Lahhamix/FYP-codebase/backend/README.md

# SoleMate Email Backend

This service relays email requests from the Android app to SendGrid.

## 1) Configure environment

Create `.env` in this folder (or copy from `.env.example`):

```
PORT=3000
SENDGRID_API_KEY=your_sendgrid_api_key_here
SENDGRID_FROM_EMAIL=your_verified_sender@example.com
SENDGRID_API_BASE_URL=https://api.sendgrid.com
```

## 2) Start backend

```bash
npm install
npm start
```

Backend health check:

- `GET http://localhost:3000/health` should return `{ "ok": true }`

## 3) Email verification API

The backend now exposes two endpoints for the Android app:

- `POST /auth/request-email-verification`
	- Body: `{ "email": "name@example.com", "username": "Jane" }`
	- Sends a verification email and starts the resend cooldown.
- `POST /auth/verify-email-code`
	- Body: `{ "email": "name@example.com", "code": "123456" }`
	- Verifies the code, marks the email as verified, and invalidates the pending code.

The verification email uses the SoleMate HTML template bundled in `server.js`.

## 4) Make app use one shared backend URL

Set one public backend URL in project `gradle.properties` (checked into git):

```
EMAIL_BACKEND_BASE_URL=https://your-public-backend.example.com
EMAIL_BACKEND_BASE_URL_DEBUG=https://your-public-backend.example.com
EMAIL_BACKEND_BASE_URL_RELEASE=https://your-public-backend.example.com
```

Notes:
- `EMAIL_BACKEND_BASE_URL_DEBUG` and `EMAIL_BACKEND_BASE_URL_RELEASE` override `EMAIL_BACKEND_BASE_URL` if set.
- Do not commit backend secrets or `.env`.
- App email sending now uses backend relay only (no direct SendGrid fallback from Android).
