Lahhamix/FYP-codebase/FYP_Template_Spring/1_cover.tex

\begin{titlepage}
\begin{center}

\LARGE{AMERICAN UNIVERSITY OF BEIRUT\\}
\vspace{3cm}

\LARGE{Project 46 - Spring Semester:\\
       SoleMate: A Custom Foot Pressure and Health Monitoring System\\} 
\vspace{1cm}

\normalsize{by\\ ~\\} 
\Large{ Raghad Al Agha, Control and Intelligence Systems - Biomedical Engineering Design \\
        Lynn Ariss, Software Systems - AI and Machine Learning \\
        Hadi Elham, Computer Hardware Systems  - AI and Machine Learning \\
        %or Control and Intelligence Systems
        Claritta Khoury, Control and Intelligence Systems - Biomedical Engineering Design \\
        ~\\
        Advisor: Ayman Kayssi\\
         Co-Advisor: Massoud Khraiche\\ 
         ~\\
    }  
\vspace{1cm}

\normalsize{A final year project\\}
\normalsize{submitted in partial fulfillment of the requirements\\}
\normalsize{for the degree of Bachelor of Engineering\\}
\small{to the Department of Electrical and Computer Engineering\\}
\normalsize{of the Maroun Semaan Faculty of Engineering and Architecture (MSFEA)\\}
\normalsize{at the American University of Beirut\\} 
\normalsize{Beirut, Lebanon\\
} 
\end{center}
\end{titlepage}
