Lahhamix/FYP-codebase/FYP_Template_Spring/Figures/3_mux .jpeg

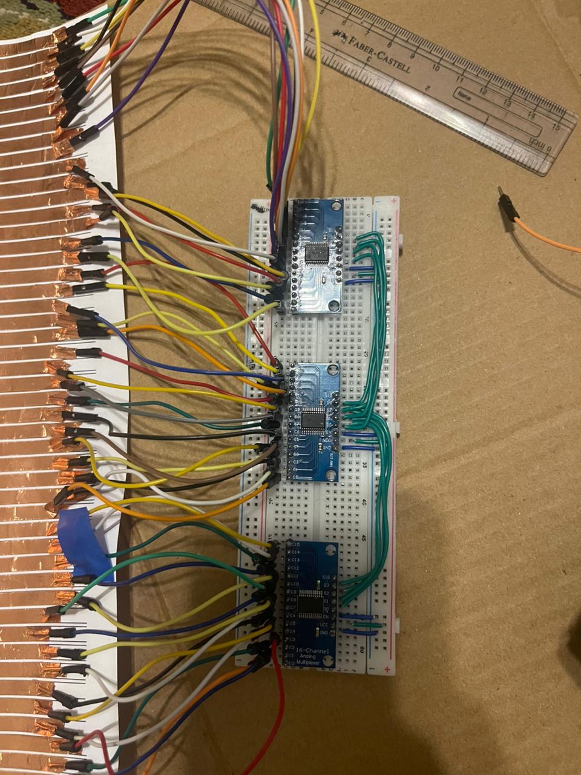
FYP_Template_Spring/Figures/3_mux .jpeg
