Lahhamix/FYP-codebase/FYP_Template_Spring/Figures/Alert_disbled.png

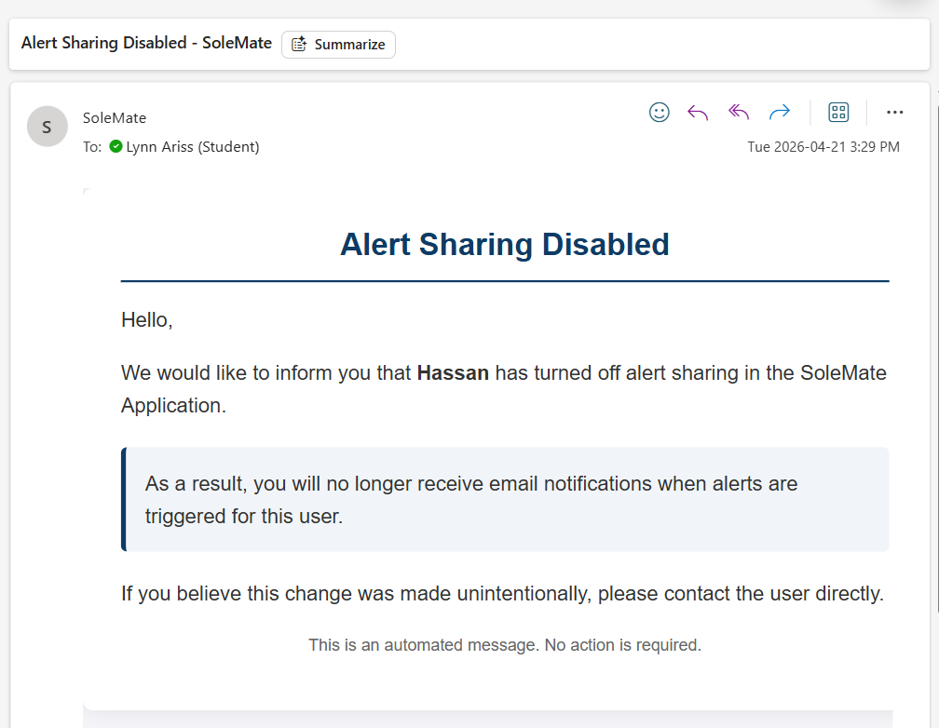
FYP_Template_Spring/Figures/Alert_disbled.png
