Lahhamix/FYP-codebase/FYP_Template_Spring/Figures/L.jpg

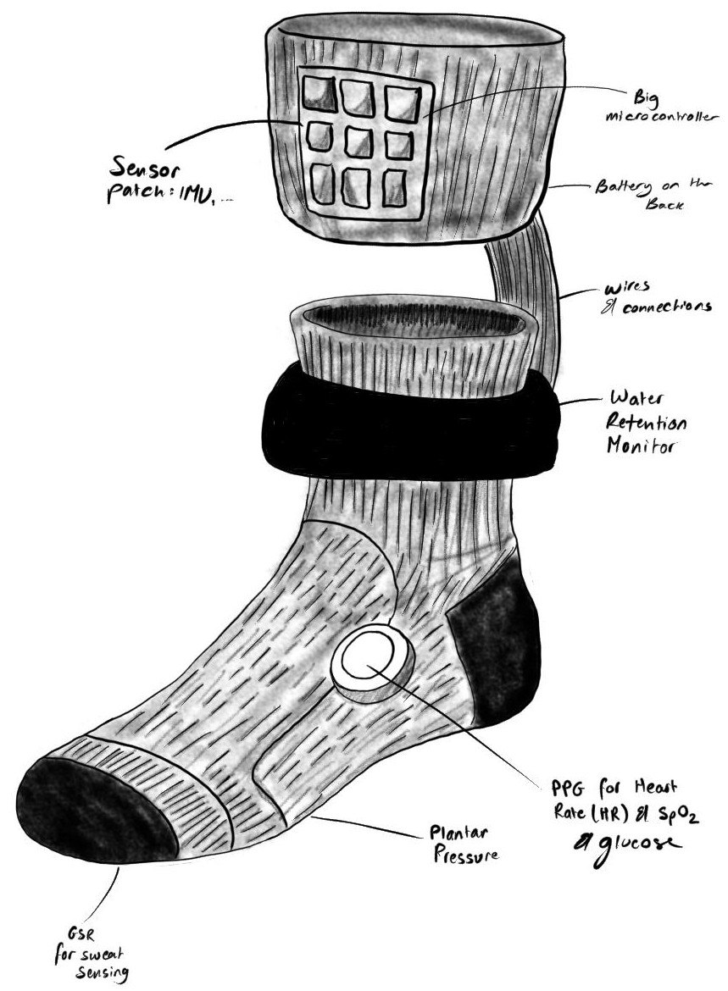
FYP_Template_Spring/Figures/L.jpg
