Lahhamix/FYP-codebase/FYP_Template_Spring/Figures/Mat.jpg

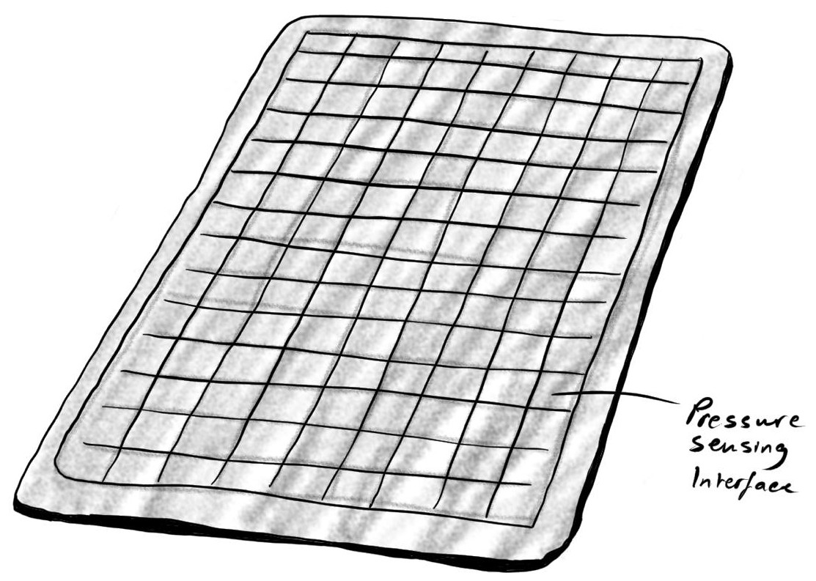
FYP_Template_Spring/Figures/Mat.jpg
