Lahhamix/FYP-codebase/FYP_Template_Spring/Figures/Remove_a_preson_from_sharing.png

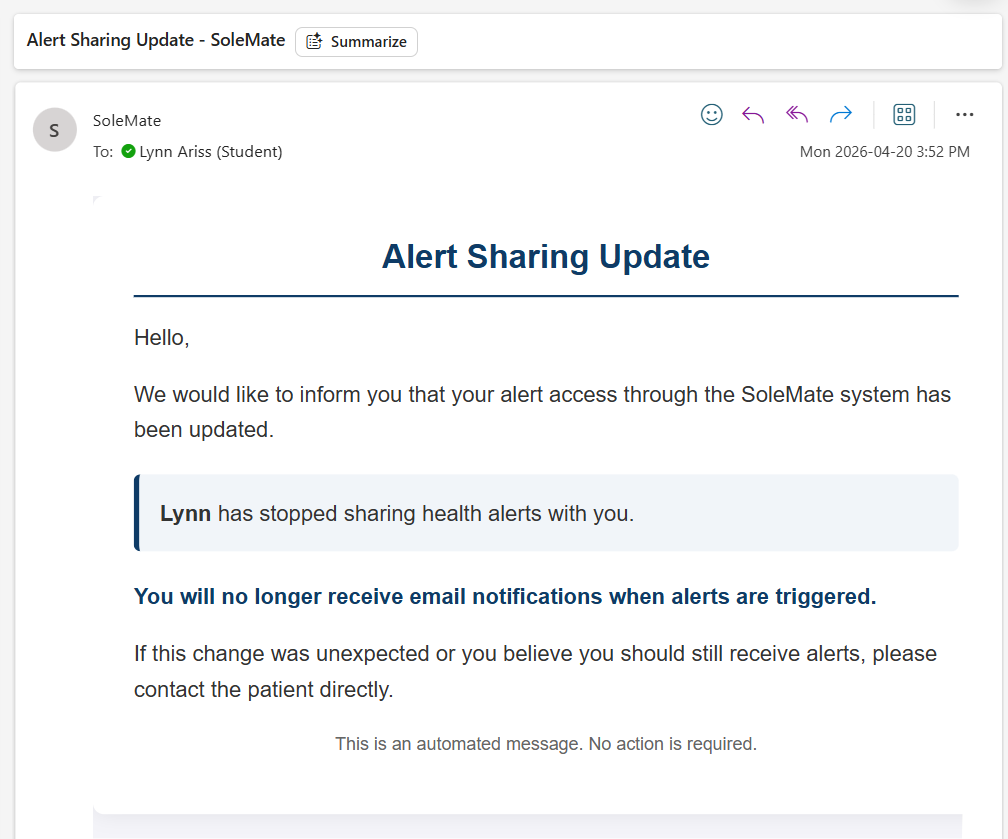
FYP_Template_Spring/Figures/Remove_a_preson_from_sharing.png
