Lahhamix/FYP-codebase/FYP_Template_Spring/Figures/Sock.jpg

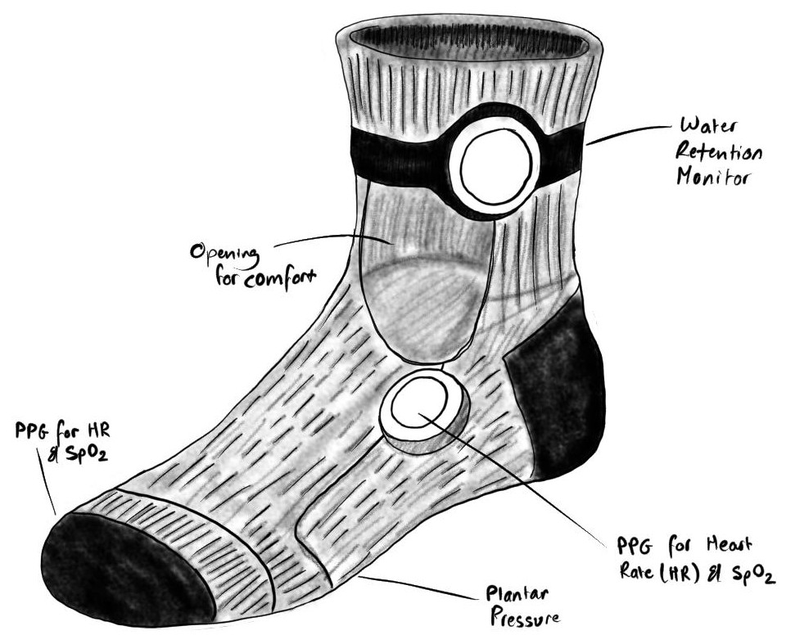
FYP_Template_Spring/Figures/Sock.jpg
