Lahhamix/FYP-codebase/FYP_Template_Spring/Figures/Signup_verification.png

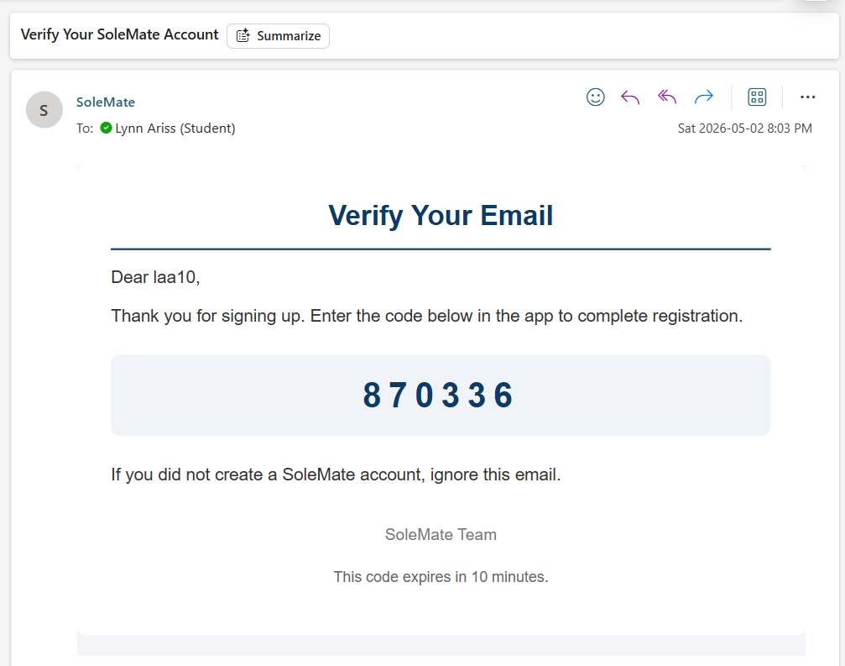
FYP_Template_Spring/Figures/Signup_verification.png
