Lahhamix/FYP-codebase/FYP_Template_Spring/Figures/Verification_alert_receipient.png

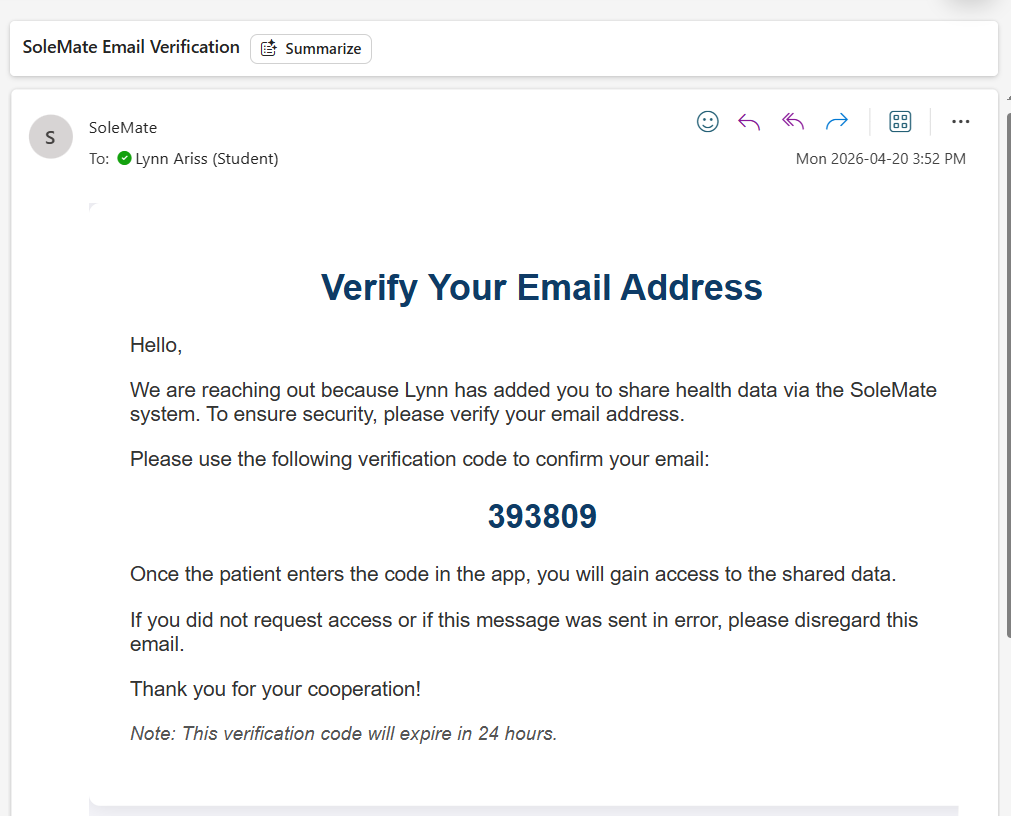
FYP_Template_Spring/Figures/Verification_alert_receipient.png
