Lahhamix/FYP-codebase/DEBUG_REPORT.md

# Backend Email & Signup Debugging Report

## Issue Summary
**Problem:** Signup requests were failing with "Could not send verification code" error on Android app
**Root Cause:** SendGrid API key exhausted its credit limit

---

## Diagnosis Process

### Step 1: Database Verification ✅
- **Status:** Database tables exist and are properly initialized
- **Tables Found:** 14/14 (users, user_profiles, user_settings, email_verification_codes, etc.)
- **Connection:** PostgreSQL on 127.0.0.1:5432 working correctly

### Step 2: Backend API Testing ✅  
- **Status:** Signup API endpoint works correctly (HTTP 201 success)
- **Test Result:** User account created successfully in database
- **Issue Found:** Email service failing silently

### Step 3: Email Service Analysis ✅
**Backend Logs Revealed:**
```
[DEV] SendGrid rejected email: Maximum credits exceeded (dev mode: continuing without email)
```
- SendGrid API key: `SG._guS82BCQKeim68j-XkkEg...` (redacted)
- Error: API key has maxed out its monthly credits
- Impact: Verification emails not being sent

---

## Solution Implemented

### Local Email Testing Mode ✅
To restore functionality while you get a new SendGrid key:

**Enabled:** Local file-based email logging
- **File Location:** `backend/email_log.txt`
- **Mode:** `USE_LOCAL_EMAIL=true` in `.env`
- **Result:** Emails are now logged to text file instead of SendGrid

**Backend Configuration:**
```
# backend/.env
USE_LOCAL_EMAIL=true
```

**Email Log Output Example:**
```
================================================================================
[2026-05-02T06:21:50.593Z]
To: test1777702909865@example.com
Subject: Verify Your SoleMate Account

Body:
Your SoleMate verification code is: 906930. It expires in 10 minutes.
```

---

## Verification Tests

| Test | Result | Status |
|---|---|---|
| PostgreSQL Connection | ✅ Working | PASS |
| Database Tables | ✅ 14/14 tables | PASS |
| User Creation | ✅ Success | PASS |
| Signup API (HTTP 201) | ✅ Success | PASS |
| Email Logging to File | ✅ Success | PASS |

---

## Next Steps

### Option 1: Restore SendGrid Email (Recommended)
When you have a new SendGrid API key:

1. Update `backend/.env`:
   ```
   SENDGRID_API_KEY=SG.YOUR_NEW_KEY_HERE
   SENDGRID_FROM_EMAIL=solemateapp26@gmail.com
   USE_LOCAL_EMAIL=false
   ```

2. Restart backend:
   ```bash
   node server.js
   ```

3. Test signup - emails will be sent via SendGrid

### Option 2: Continue with Local Testing
- Current setup allows unlimited local testing
- No SendGrid credits needed
- Verification codes logged in `email_log.txt`
- Good for development/testing phase

---

## Important Files Modified

- [backend/src/services/email.service.js](backend/src/services/email.service.js) - Added local email logging
- [backend/.env](backend/.env) - Added `USE_LOCAL_EMAIL` toggle

---

## How It Works Now

```
Signup Request → Create User → Generate Verification Code → Save to Database → Log Email to File
      ✅                 ✅                  ✅                    ✅            ✅
```

All components working! Emails are now being logged locally.

---

## To Get a New SendGrid API Key

1. Go to https://sendgrid.com
2. Sign in or create account
3. Create a new API key in Settings → API Keys
4. Copy the key (format: `SG.xxxxx`)
5. Update `backend/.env` and restart

---

**Status:** ✅ Backend is now fully operational with local email testing enabled
**Date Debugged:** May 2, 2026
**Backend Version:** v2 (Express + PostgreSQL)
