Lahhamix/FYP-codebase/FYP_Template_Spring/Minutes/Meeting Minutes 10.pdf

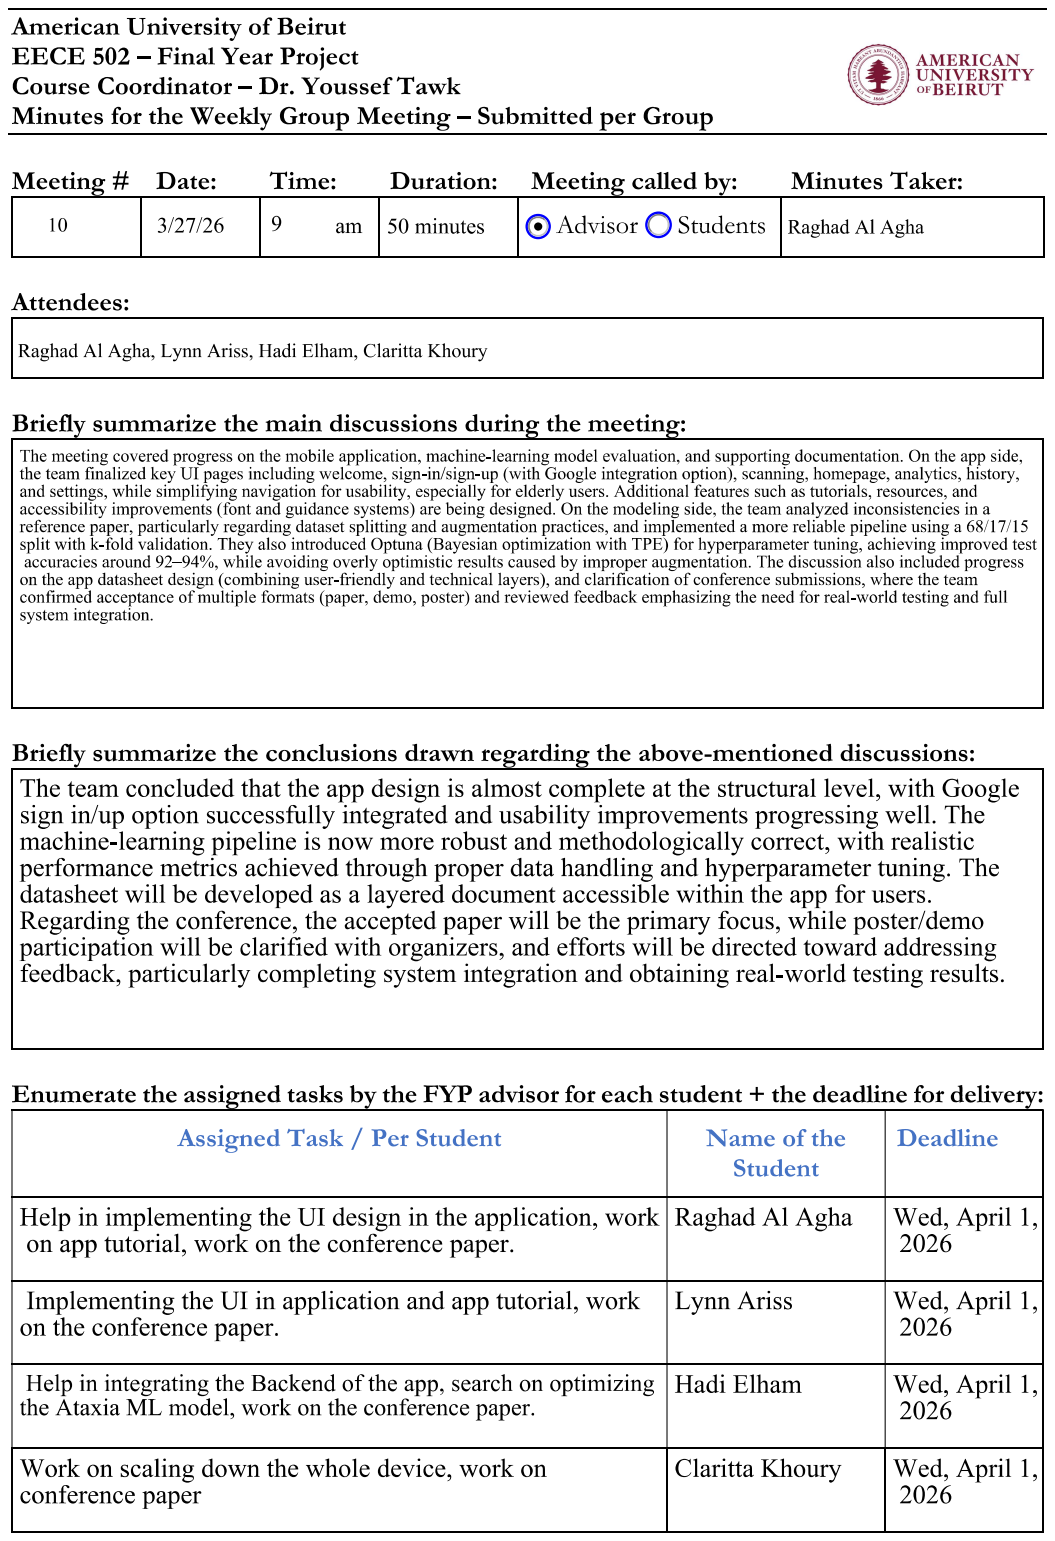
[picture p39: page 1]
