Lahhamix/FYP-codebase/FYP_Template_Spring/Minutes/Meeting Minutes 12.pdf

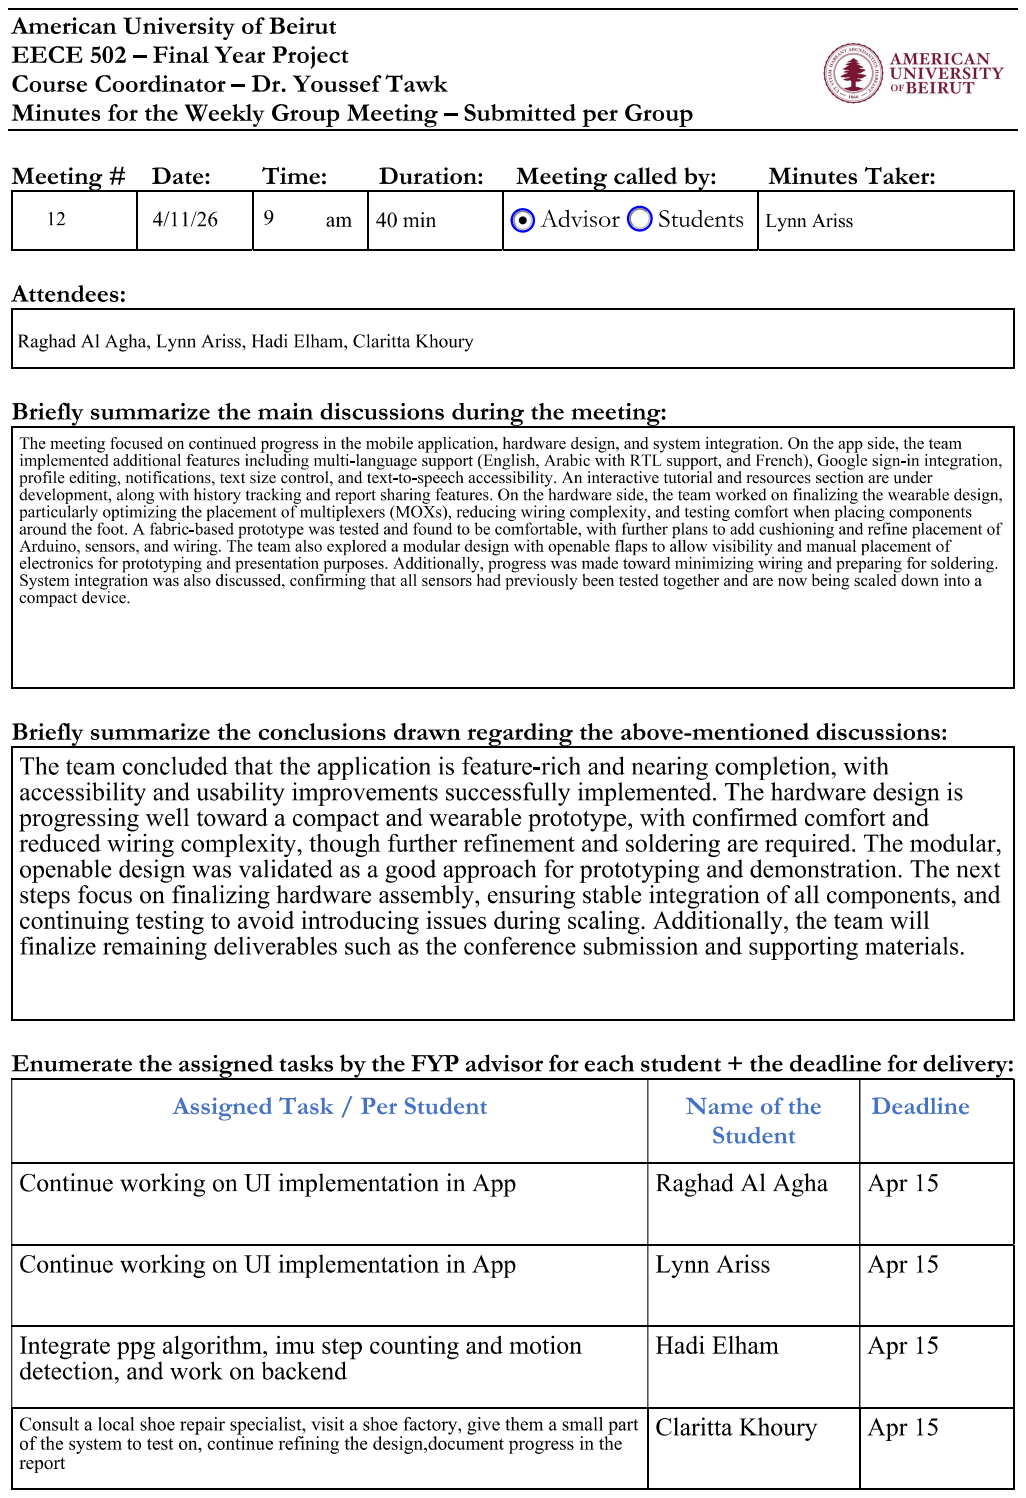
[picture p40: page 1]
