Lahhamix/FYP-codebase/FYP_Template_Spring/Minutes/Meeting Minutes 13.pdf

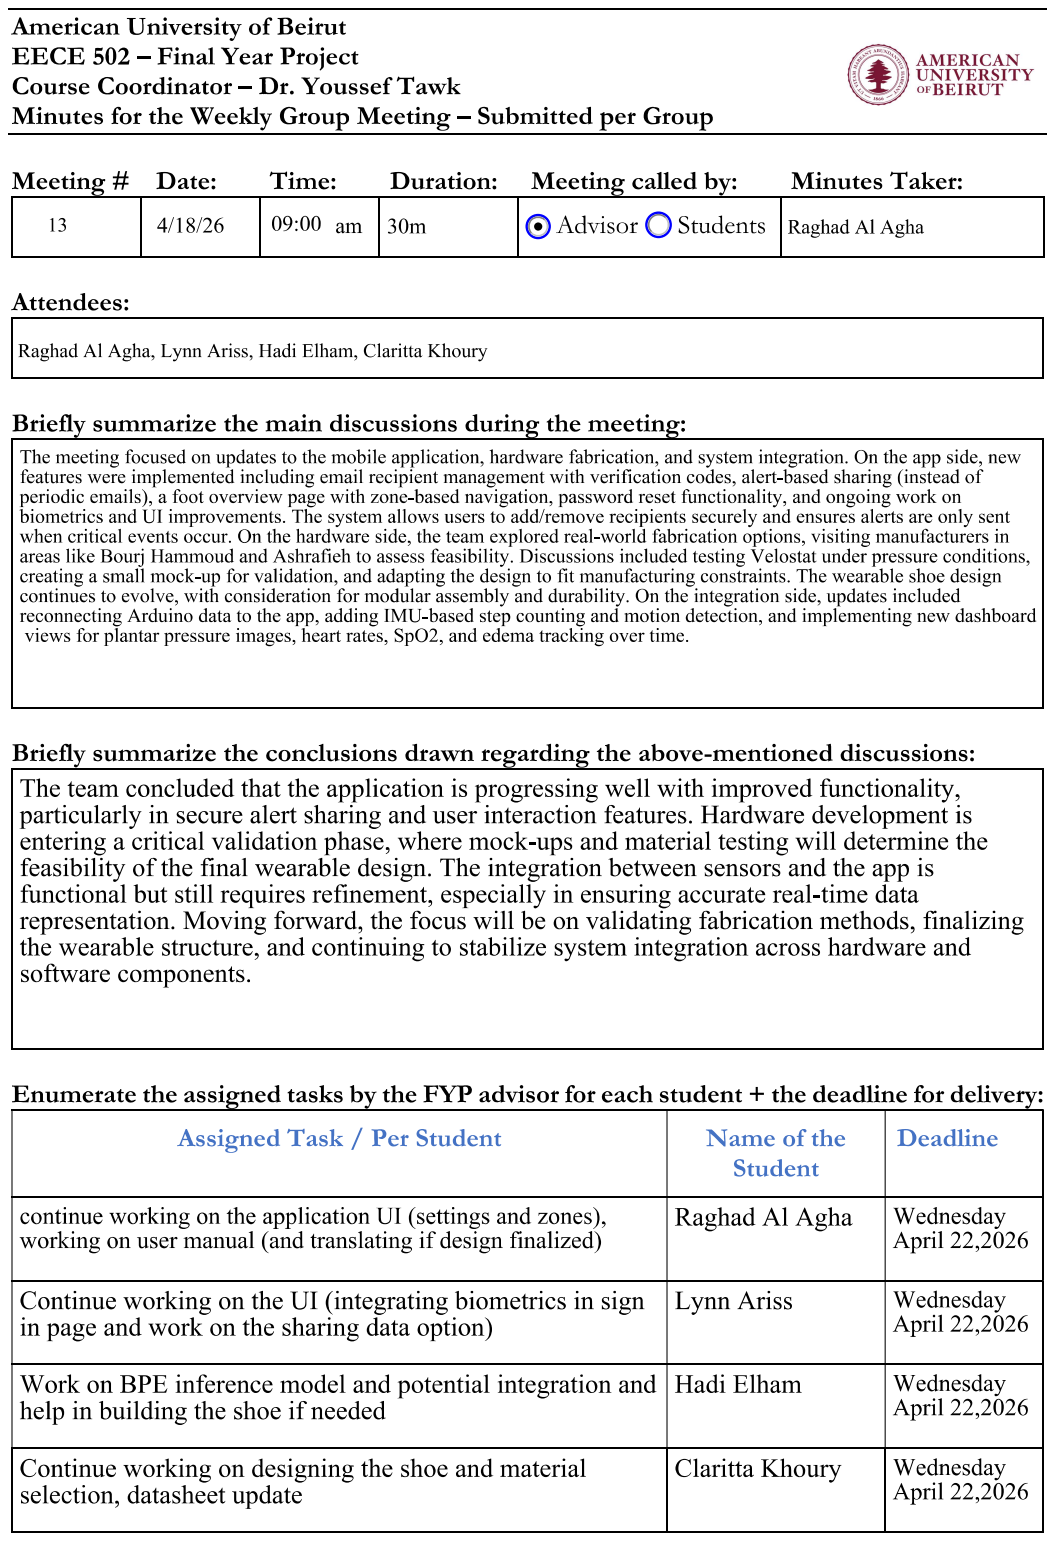
[picture p41: page 1]
