Lahhamix/FYP-codebase/FYP_Template_Spring/Minutes/Meeting Minutes 14.pdf

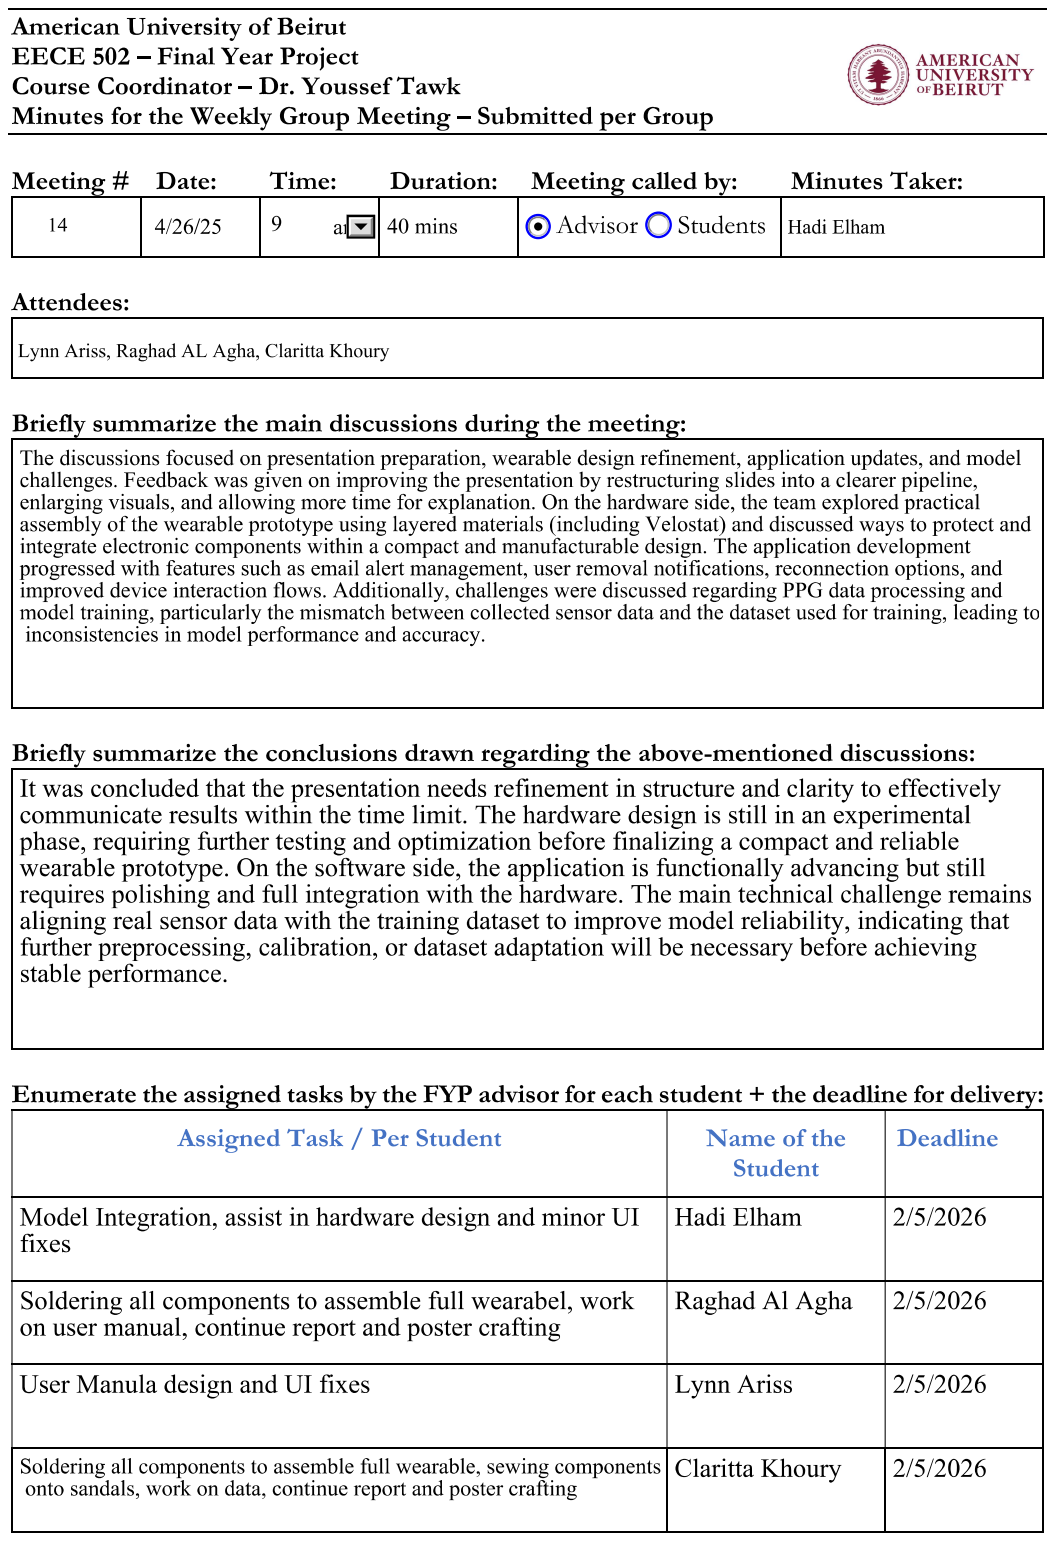
[picture p42: page 1]
