Lahhamix/FYP-codebase/FYP_Template_Spring/Minutes/Meeting Minutes 2.pdf

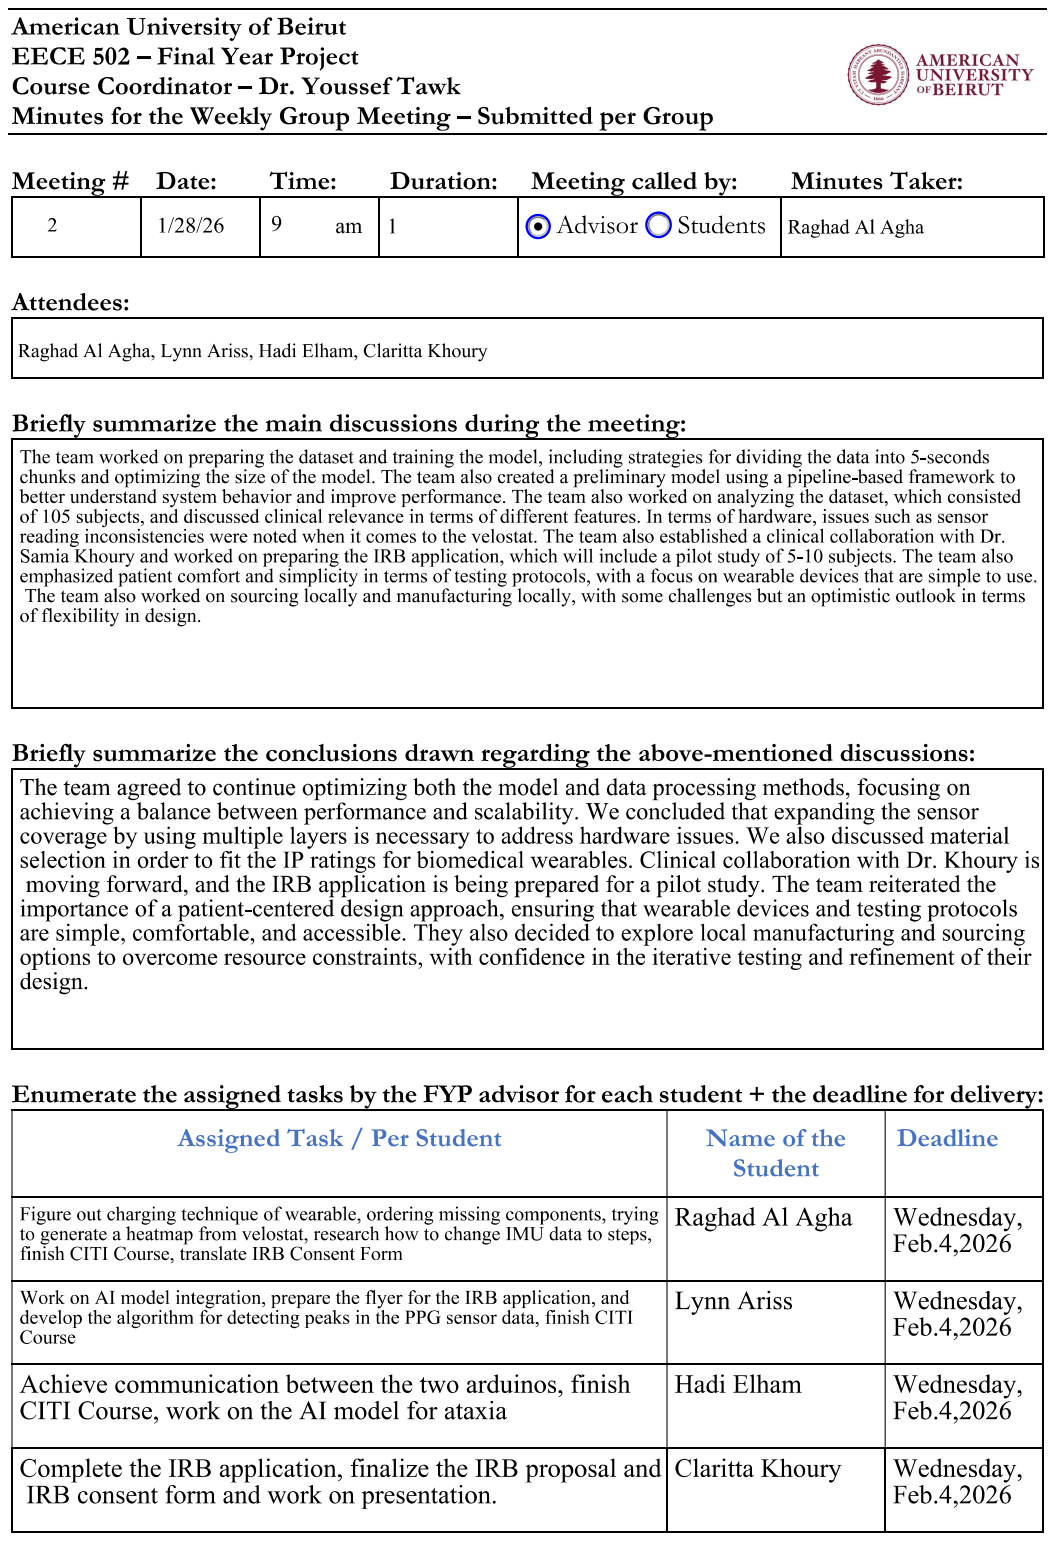
[picture p43: page 1]
