Lahhamix/FYP-codebase/FYP_Template_Spring/Minutes/Meeting Minutes 3.pdf

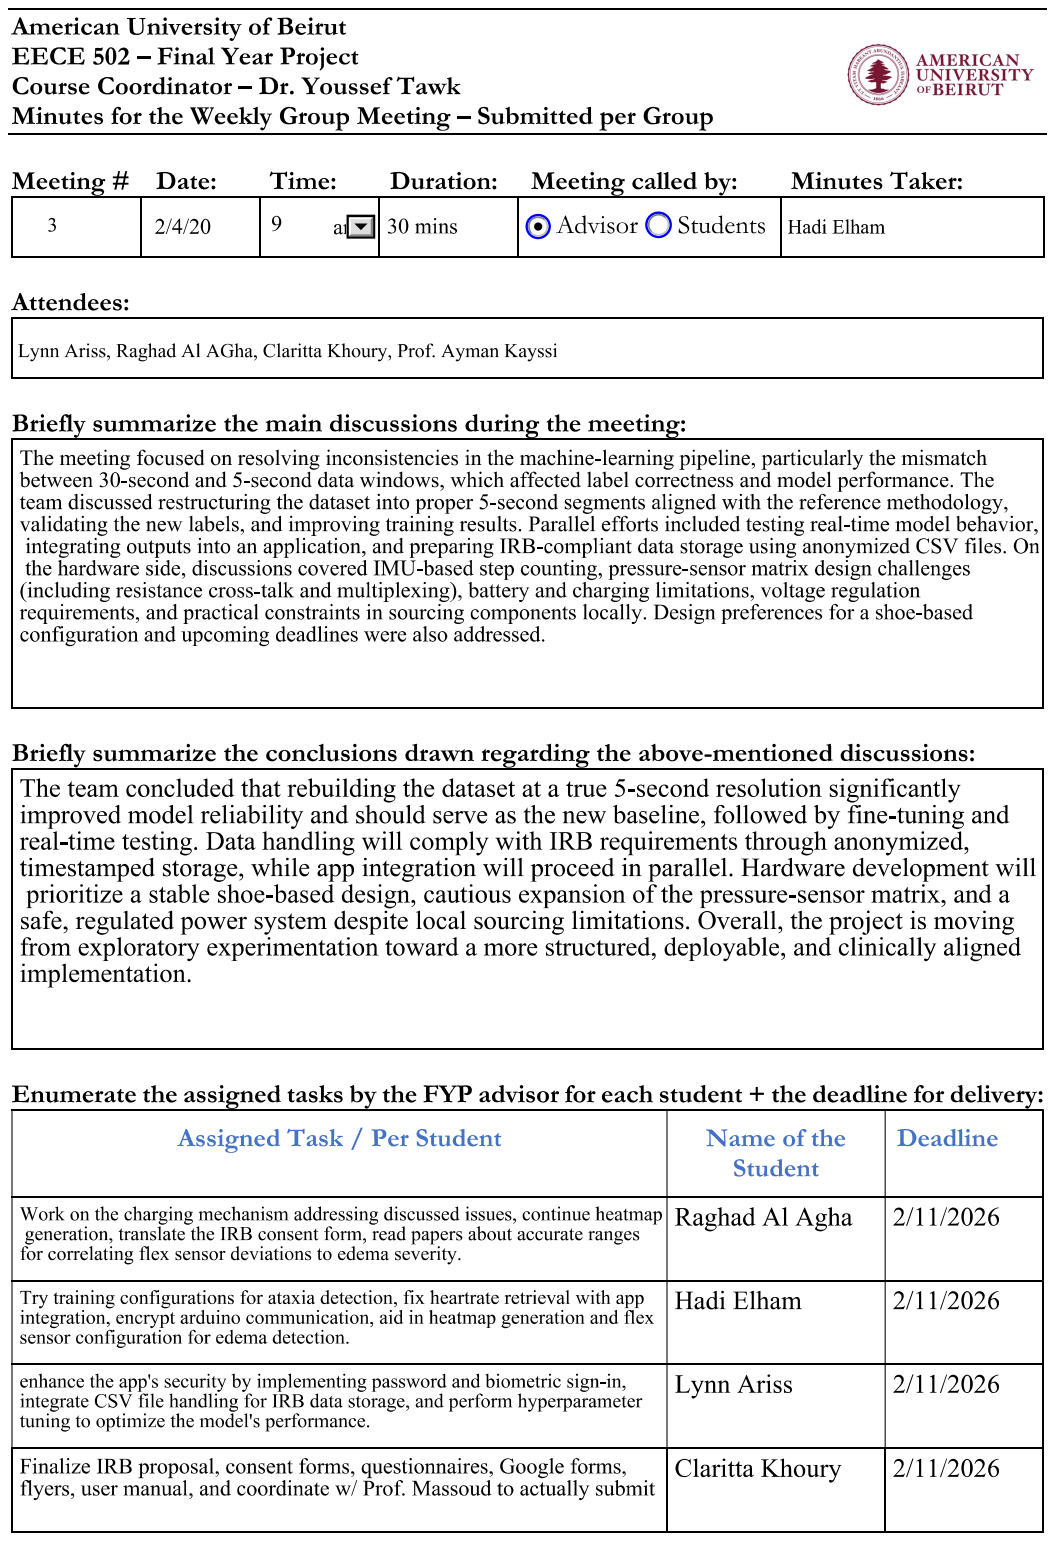
[picture p44: page 1]
