Lahhamix/FYP-codebase/FYP_Template_Spring/Minutes/Meeting Minutes 4.pdf

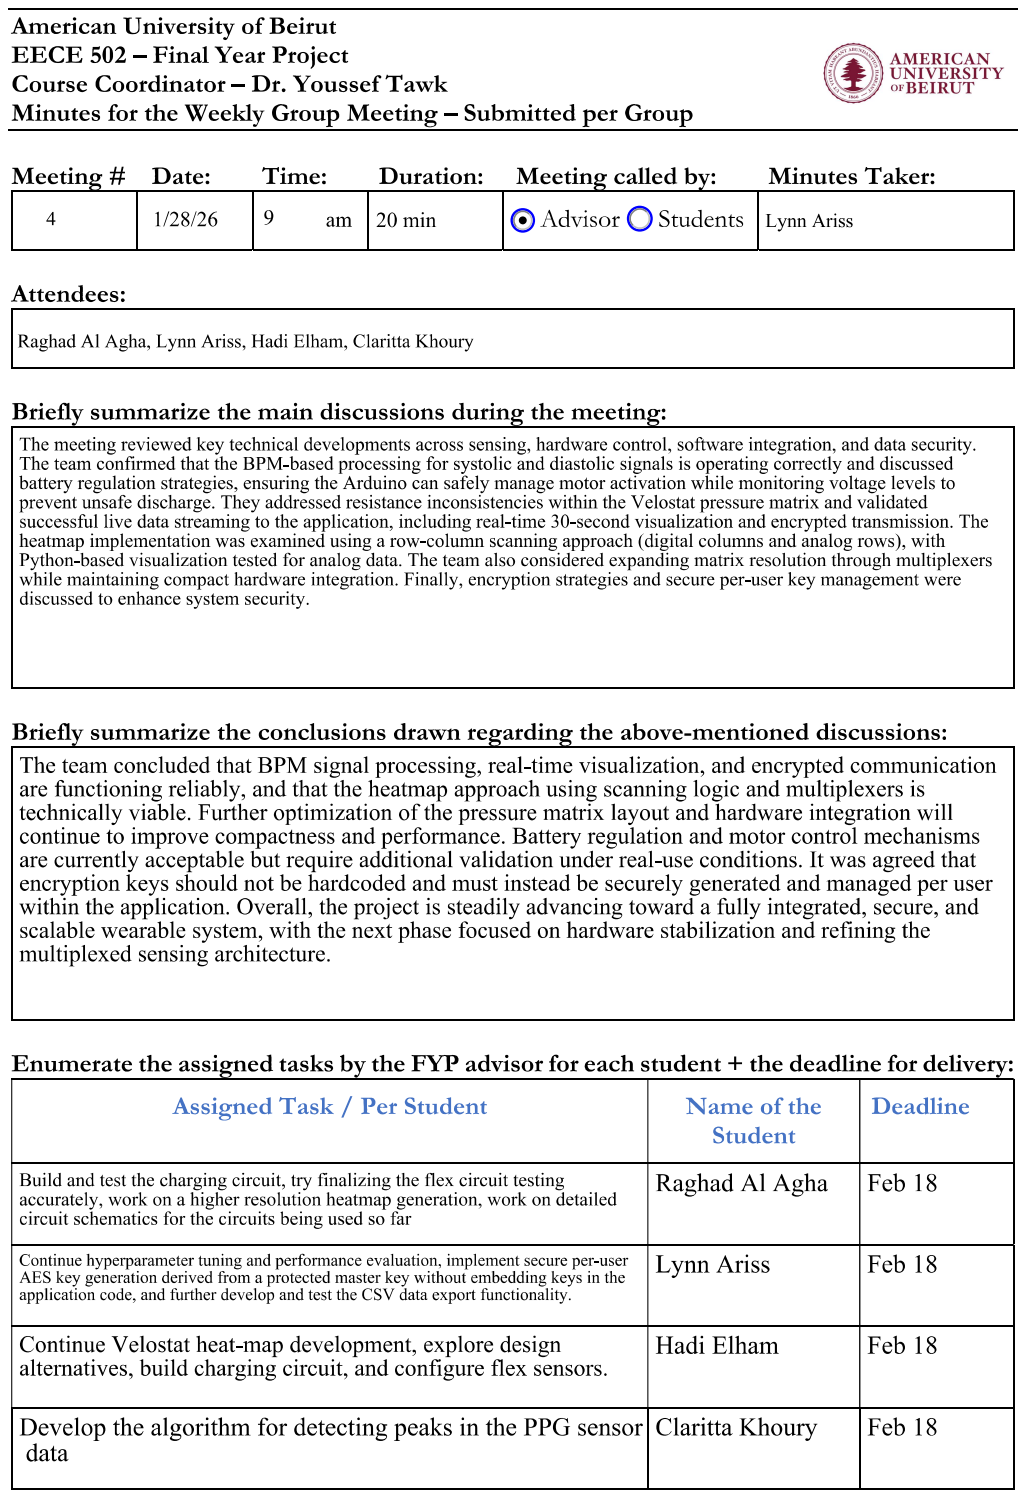
[picture p45: page 1]
