Lahhamix/FYP-codebase/FYP_Template_Spring/Minutes/Meeting Minutes 7.pdf

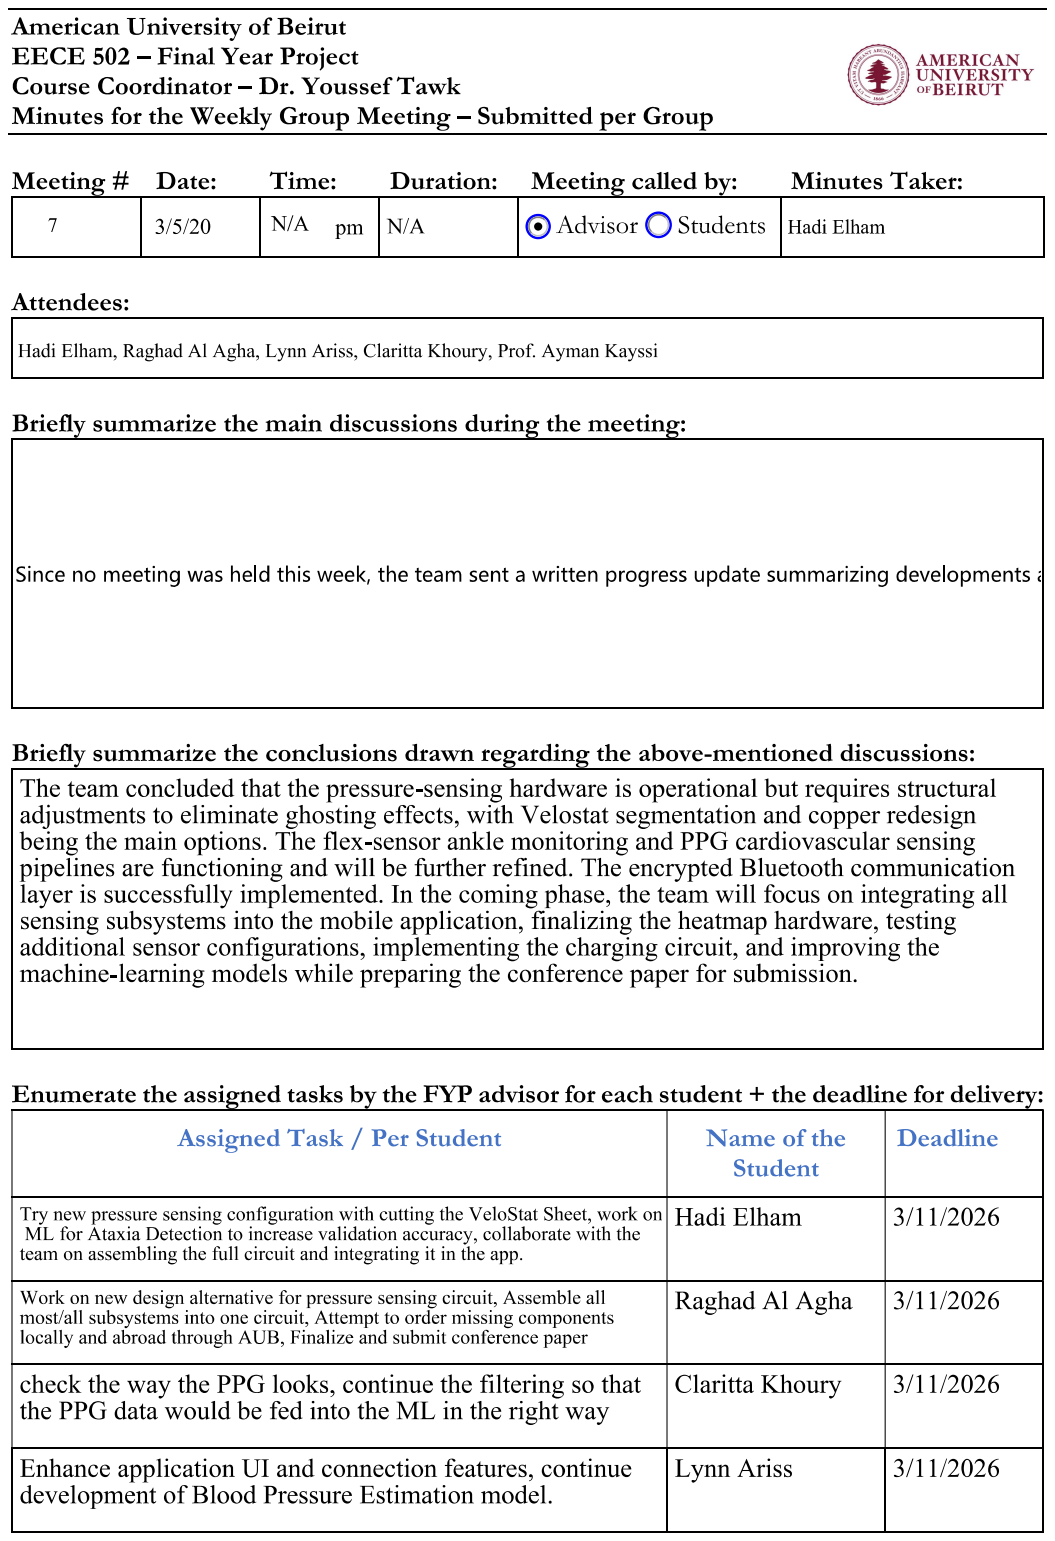
[picture p46: page 1]
