Lahhamix/FYP-codebase/FYP_Template_Spring/Minutes/Meeting Minutes 8.pdf

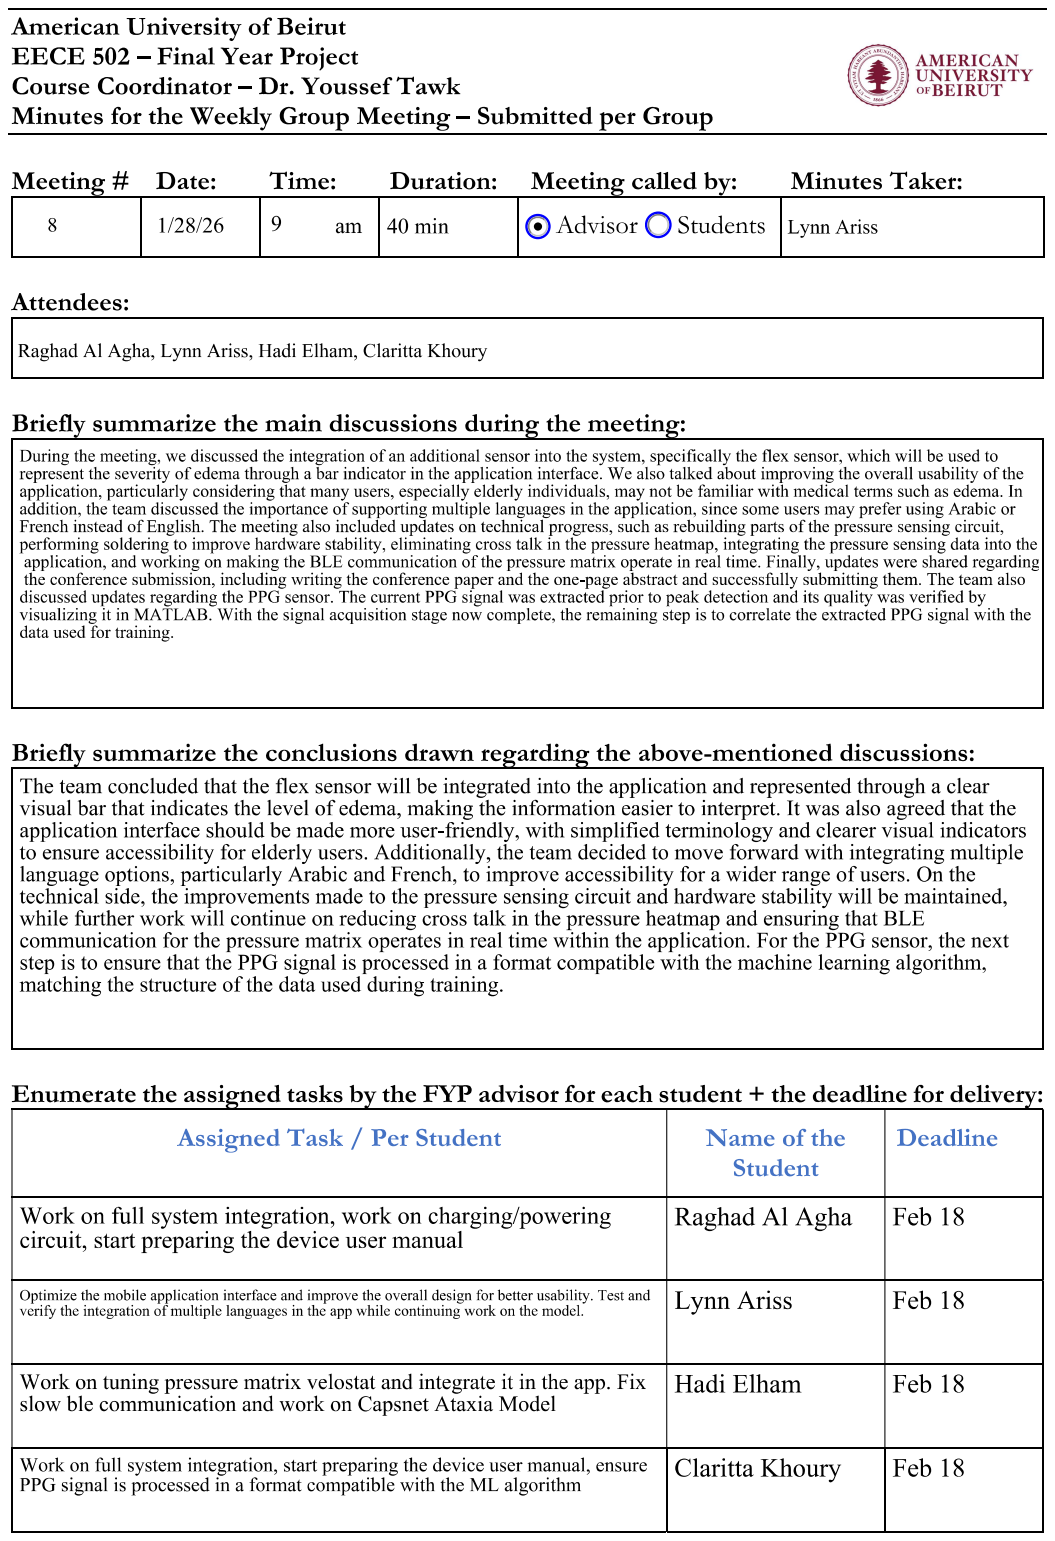
[picture p47: page 1]
