Lahhamix/FYP-codebase/FYP_Template_Spring/Minutes/Meeting Minutes 9.pdf

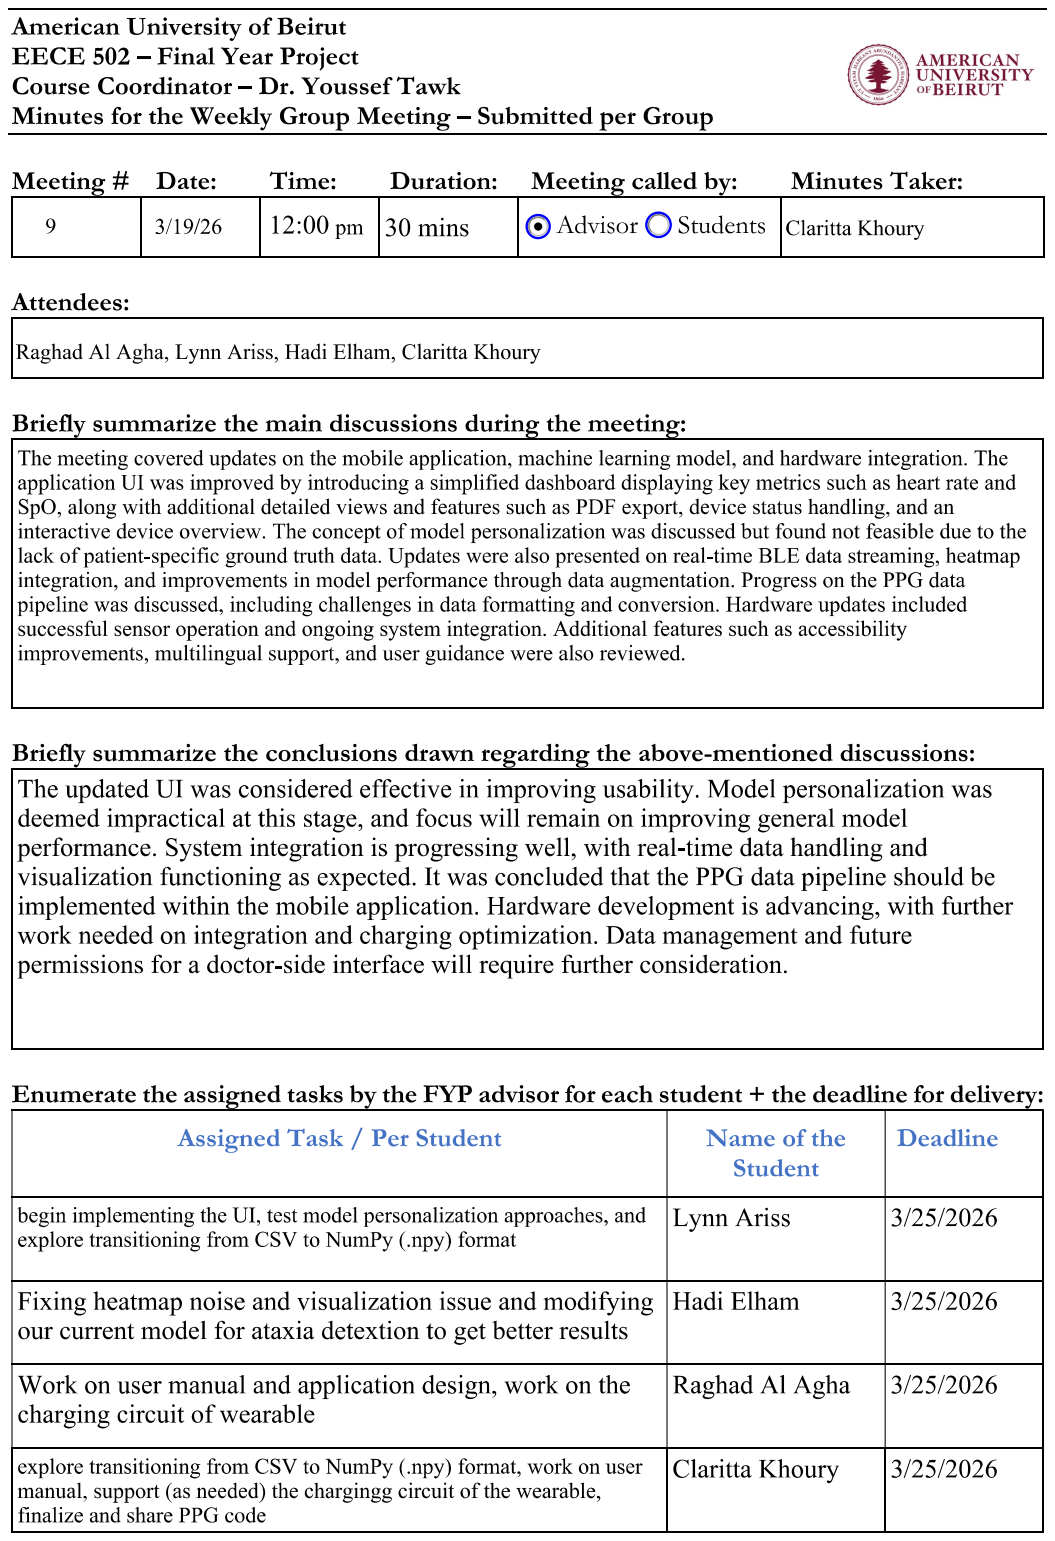
[picture p48: page 1]
