Lahhamix/FYP-codebase/arduinobackend/encryption.cpp

#include "encryption.h"
#include "key_exchange.h"
#include <string.h>
#include "serial_log.h"

// IVs - MUST match AESCrypto.kt exactly (steps: 0x00..0x0F, motion: 0x10..0x1F, etc.)
static const uint8_t stepsIV[16] = {
  0x00, 0x01, 0x02, 0x03, 0x04, 0x05, 0x06, 0x07,
  0x08, 0x09, 0x0A, 0x0B, 0x0C, 0x0D, 0x0E, 0x0F
};

static const uint8_t motionIV[16] = {
  0x10, 0x11, 0x12, 0x13, 0x14, 0x15, 0x16, 0x17,
  0x18, 0x19, 0x1A, 0x1B, 0x1C, 0x1D, 0x1E, 0x1F
};

static const uint8_t heartRateIV[16] = {
  0x20, 0x21, 0x22, 0x23, 0x24, 0x25, 0x26, 0x27,
  0x28, 0x29, 0x2A, 0x2B, 0x2C, 0x2D, 0x2E, 0x2F
};

static const uint8_t spo2IV[16] = {
  0x30, 0x31, 0x32, 0x33, 0x34, 0x35, 0x36, 0x37,
  0x38, 0x39, 0x3A, 0x3B, 0x3C, 0x3D, 0x3E, 0x3F
};

static const uint8_t flexIV[16] = {
  0x40, 0x41, 0x42, 0x43, 0x44, 0x45, 0x46, 0x47,
  0x48, 0x49, 0x4A, 0x4B, 0x4C, 0x4D, 0x4E, 0x4F
};

static const uint8_t pressureIV[16] = {
  0x50, 0x51, 0x52, 0x53, 0x54, 0x55, 0x56, 0x57,
  0x58, 0x59, 0x5A, 0x5B, 0x5C, 0x5D, 0x5E, 0x5F
};

static const uint8_t ppgWaveIV[16] = {
  0x60, 0x61, 0x62, 0x63, 0x64, 0x65, 0x66, 0x67,
  0x68, 0x69, 0x6A, 0x6B, 0x6C, 0x6D, 0x6E, 0x6F
};

// Keys from key exchange (populated after ECDH)
static uint8_t stepsKey[16];
static uint8_t motionKey[16];
static uint8_t heartRateKey[16];
static uint8_t spo2Key[16];
static uint8_t flexKey[16];
static uint8_t pressureKey[16];
static uint8_t ppgWaveKey[16];

static bool encryptionReady = false;

AES128 aes128;
CBC<AES128> cbc;

void encryption_init_from_key_exchange() {
  if (!key_exchange_is_complete()) {
    LOG_ENCRYPT(Serial.println("[ENCRYPTION] Key exchange not complete, cannot init."));
    return;
  }
  key_exchange_get_steps_key(stepsKey);
  key_exchange_get_motion_key(motionKey);
  key_exchange_get_heart_rate_key(heartRateKey);
  key_exchange_get_spo2_key(spo2Key);
  key_exchange_get_flex_key(flexKey);
  key_exchange_get_pressure_key(pressureKey);
  key_exchange_get_ppg_wave_key(ppgWaveKey);
  encryptionReady = true;
  cbc.setKey(stepsKey, 16);
  cbc.setIV(stepsIV, 16);
}

void encryption_init() {
  // Legacy fallback - not used when key exchange is active
  encryptionReady = false;
}

bool encryption_is_ready() {
  return encryptionReady;
}

size_t addPKCS5Padding(const uint8_t* data, size_t dataLen, uint8_t* paddedData, size_t maxLen) {
  if (dataLen == 0 || dataLen > maxLen - 16) {
    return 0;
  }

  uint8_t padValue = 16 - (dataLen % 16);
  if (padValue == 0) padValue = 16;

  if (dataLen + padValue > maxLen) {
    return 0;
  }

  memcpy(paddedData, data, dataLen);
  for (size_t i = dataLen; i < dataLen + padValue; i++) {
    paddedData[i] = padValue;
  }
  return dataLen + padValue;
}

bool encryptWithKeyIV(const String& plaintext, const uint8_t* key, const uint8_t* iv, EncryptedPayload& payload) {
  if (!encryptionReady) {
    return false;
  }
  if (plaintext.length() == 0) {
    LOG_ENCRYPT(Serial.println("ERROR: Empty plaintext"));
    return false;
  }

  size_t plaintextLen = plaintext.length();
  const size_t MAX_PLAINTEXT = 64;
  if (plaintextLen > MAX_PLAINTEXT) {
    LOG_ENCRYPT(Serial.println("ERROR: Plaintext too long"));
    return false;
  }

  uint8_t plaintextBytes[MAX_PLAINTEXT];
  for (size_t i = 0; i < plaintextLen; i++) {
    plaintextBytes[i] = (uint8_t)plaintext.charAt(i);
  }

  uint8_t paddedData[MAX_PLAINTEXT + 16];
  size_t actualPaddedLen = addPKCS5Padding(plaintextBytes, plaintextLen, paddedData, MAX_PLAINTEXT + 16);
  if (actualPaddedLen == 0 || actualPaddedLen > sizeof(payload.data)) {
    LOG_ENCRYPT(Serial.println("ERROR: Padding failed or output too large"));
    return false;
  }

  cbc.setKey(key, 16);
  cbc.setIV(iv, 16);
  cbc.encrypt(payload.data, paddedData, actualPaddedLen);
  payload.length = actualPaddedLen;
  return true;
}

bool encryptSteps(const String& plaintext, EncryptedPayload& payload) {
  return encryptWithKeyIV(plaintext, stepsKey, stepsIV, payload);
}

bool encryptMotion(const String& plaintext, EncryptedPayload& payload) {
  return encryptWithKeyIV(plaintext, motionKey, motionIV, payload);
}

bool encryptHeartRate(const String& plaintext, EncryptedPayload& payload) {
  return encryptWithKeyIV(plaintext, heartRateKey, heartRateIV, payload);
}

bool encryptSpO2(const String& plaintext, EncryptedPayload& payload) {
  return encryptWithKeyIV(plaintext, spo2Key, spo2IV, payload);
}

bool encryptFlex(const String& plaintext, EncryptedPayload& payload) {
  return encryptWithKeyIV(plaintext, flexKey, flexIV, payload);
}

bool encryptPpgWaveChunk(const uint8_t* plaintext, size_t plaintextLen, EncryptedPayload& payload) {
  if (!encryptionReady || plaintext == nullptr || plaintextLen == 0) {
    return false;
  }
  const size_t MAX_PLAINTEXT = 64;
  if (plaintextLen > MAX_PLAINTEXT) {
    return false;
  }
  uint8_t padded[MAX_PLAINTEXT + 16];
  size_t actualPaddedLen = addPKCS5Padding(plaintext, plaintextLen, padded, sizeof(padded));
  if (actualPaddedLen == 0 || actualPaddedLen > sizeof(payload.data)) {
    return false;
  }
  cbc.setKey(ppgWaveKey, 16);
  cbc.setIV(ppgWaveIV, 16);
  cbc.encrypt(payload.data, padded, actualPaddedLen);
  payload.length = actualPaddedLen;
  return true;
}

bool encryptPressurePayload(const uint8_t* payload, size_t payloadLen, uint8_t* encryptedOut, size_t* encryptedLen) {
  if (!encryptionReady || payloadLen == 0 || payloadLen > 12) {
    return false;
  }

  // Pad payload to 16 bytes (AES block size)
  uint8_t paddedData[16];
  memcpy(paddedData, payload, payloadLen);
  uint8_t padValue = 16 - payloadLen;
  for (size_t i = payloadLen; i < 16; i++) {
    paddedData[i] = padValue;
  }

  cbc.setKey(pressureKey, 16);
  cbc.setIV(pressureIV, 16);
  cbc.encrypt(encryptedOut, paddedData, 16);
  *encryptedLen = 16;
  return true;
}
