Lahhamix/FYP-codebase/(commit log)

2025-11-24 Developed Arduino Backend with Encryption
2026-03-13 Integrated flex on android
    [PH_BLE_12bit.ino, flex_reader.cpp, flex_reader.h]
2026-03-15 Integrated Pressure Heatmap with Calibration and Encryption
2026-04-04 Turning the Cancel button in the scanning to Skip for now and adding some adjustments
2026-04-06 Add Device Alerts toggle with notification permission flow
2026-04-06 Refine profile editing flow
2026-04-12 fixed backend, added imu step counting and motion detection, and minor UI fixes
    [ExpectedGoodQualitySignals.csv, TestingHR.xlsx, filtered_ppg_data.csv, filtered_ppg_data_Transpose.csv]
2026-04-23 Toolbar fix, addition of app lock and fix for the security section
    [dialog_app_lock_info.xml]
2026-04-25 Fix UI of foot overview, fix back button, and add the initial flex page design
2026-04-26 integrated BPE model, fixed arduino backend and minor UI fixes
    [ExpectedGoodQualitySignals.csv, TestingHR.xlsx, filtered_ppg_data.csv, filtered_ppg_data_Transpose.csv]
2026-04-29 lynn did some stuff, im hadi pushing from her laptop
    [activity_app_lock.xml]
2026-05-02 Deploy full backend v2 to Railway
    Replaces the minimal email-relay server with a full Node.js/Express backend:
    - JWT auth (register, login, email verification, password reset)
    - Google Sign-In via google-auth-library
    - PostgreSQL via pg with full schema migration
    - SendGrid email service
    - Rate limiting, validation, structured error handling
2026-05-02 Fix Railway PostgresSQL
2026-05-04 new BPE model, Pressure heatmap live, database unknown fixes
    [PHBLE_APP.ino, PH_BLE_12bit.ino]
2026-05-04 Add /send-email endpoint and Railway backend config
